UCSC-iGEM-2016/taris_controller/(list of files, drawings)

Other design files:
schematics/mainboard.dch
schematics/mainboard_pcb_v1.dip
