UCSC-iGEM-2016/taris_controller/taris_controller/taris_motors.py

#!/usr/bin/env python

from __future__ import print_function    # reconciles printing between python2 and python3
import os
import io
import taris_reactor as reactor

# Uses pi-blaster to run a PWM from the raspberry pi pins.
# Once pi-blaster is installed on the pi, bash commands 
# can control the PWM output of individual pins.
# 
# Bash examples (taken from https://github.com/sarfata/pi-blaster): 
#
# This command sets pin 17 to 100%:
#### > echo "17=1" > /dev/pi-blaster 
#
# This command sets pin 17 to 20%:
#### > echo "17=0.2" > /dev/pi-blaster 
#
# This command sets pin 17 to 0%:
#### > echo "17=0" > /dev/pi-blaster
#
# This command releases a pin for use as a GPIO or an input again:
#### > echo "release 17" > /dev/pi-blaster
# 
# To override the default list of supported GPIO pins and specify 
# fewer (or more) you can specify a comma separated list of GPIO 
# numbers. This is also the default list:
#### > ./pi-blaster --gpio 4,17,18,27,21,22,23,24,25
#
# To use the BCM2835's PCM peripheral instead of its PWM peripheral
# to time the DMA transfers, pass the option:
#### > ./pi-blaster --pcm
# 
# To invert the pulse (off = pin HIGH, pulse = pin LOW), use:
#### > ./pi-blaster --invert
# 
# To keep pi-blaster running in the foreground without running 
# as a daemon use:
#### > ./pi-blaster -D
# 
# To view help or version information, use:
#### > ./pi-blaster --help
#### > ./pi-blaster --version

#PINd = 22
#PWMd = 0
#PINd = str(PINd)
#PWMd = str(PWMd)
#os.system("echo '" + PINd + "=" + PWMd + "' > /dev/pi-blaster")

class Taris_Motors():
    
    def __init__(self, inPWM, outPWM, naohPWM, heaterPWM, Kp, Ki, Kd, pH_def, temp_def):
        self.inPWM       = inPWM
        self.outPWM      = outPWM
        self.naohPWM     = naohPWM
        self.heaterPWM   = heaterPWM
        
        self.inPIN       = 21         # Inflow motor default pin:    21
        self.outPIN      = 22         # Outflow motor default pin:   22
        self.naohPIN     = 23         # NaOH motor default pin:      23
        self.heaterPIN   = 17         # Heating element default pin: 17

        # PID Function Variables
        self.current_val      = 0.0
        self.end_val          = 0.0
        self.sample_time      = 0.0
        self.integral_prev    = 0.0
        self.error_prev       = 0.0
        self.Kp = Kp
        self.Ki = Ki
        self.Kd = Kd

        # pH Variables
        self.pH_desired     = pH_def  # the pH you desire <3
        self.pH_current     = 0.0     # the pH that is actually happening >.>
        self.fluid_volume   = 2.0     # liters of liquid in the bioreactor
        self.NaOH_molarity  = 0.0001  # grams/liter of NaOH solution to be added
        self.rate_of_NaOH   = 0.0001  # liters/second (based on each motor)

        # Temperature Variables (PI)
        self.desired_temp     = temp_def # Celsius
        self.current_temp     = 0.0
        self.temp_Kp          = 0.0
        self.temp_Ki          = 0.0
        self.temp_error       = 0.0
        self.temp_sample_time = 0.0
        self.temp_curr_time   = 0.0
        self.temp_prev_time   = 0.0
        self.temp_P           = 0.0
        self.temp_I           = 0.0
        self.temp_I_MAX       = 0.0
        self.temp_I_MIN       = 0.0
        self.set_power        = 0.0

        # initiate pi-blaster with only the four default pins above
        os.system("sudo pi-blaster --gpio 17,21,22,23")

    def set_PIN_at_PWM(self, PIN, PWM):
        PIN = str(PIN)
        PWM = str(PWM)
        print("Setting pin " + PIN + " to " + PWM + ".")
        os.system("echo '" + PIN + "=" + PWM + "' > /dev/pi-blaster")

    def set_volume(self, volume):
        self.fluid_volume = volume
        pass

    def set_rate_of_NaOH(self, rate):
        self.rate_of_NaOH = rate
        pass

    def set_NaOH_molarity(self, molarity):
        self.NaOH_molarity = molarity
        pass

    def set_pH_desired(self, pH):
        self.pH_desired = pH
        pass

    def set_temp_desired(self, temp):
        self.desired_temp = temp
        pass

    def bangbang_heater(self, input_temp):
        """
        Simple bang-bang hysteresis control of the heating element.
        """
        upper_threshold = self.desired_temp + 0.5
        lower_threshold = self.desired_temp - 0.5

        if input_temp > upper_threshold:
            self.set_power = 0
        if input_temp < lower_threshold:
            self.set_power = 1
	return self.set_power

    def pH(self, input_pH):
        """
        When run, this function adds NaOH to the bioreactor to adjust pH.

        Designed to be run as a daemon.  Whenever the pH dips 0.1 below the desired
        pH, this function will calculate the volume of NaOH to be added, and will 
        run the motor an amount of time long enough to add that amount (and if not 
        run as a daemon, will pause the entire program).

        Motor rate of NaOH addition and volume must be entered beforehand.

        It is important that this function be given an average of pH values to avoid 
        spikes and noise.

        It's a good idea to pause after using this function to allow the pH stick
        to acclimate.
        """

        moles_of_NaOH = (fluid_volume*(10**(-pH_desired))) - (fluid_volume*(10**(-pH_current)))
        vol_of_NaOH_to_add = moles_of_NaOH / NaOH_molarity
        run_motor_for_how_long = rate_of_NaOH / vol_of_NaOH_to_add

        self.set_PIN_at_PWM(self.naohPIN, 0.1) # 0.1 = run at one-tenth motor power
        time.sleep(run_motor_for_how_long)
        self.set_PIN_at_PWM(self.naohPIN, 0) # 0 = stop the motor

    def PID(self, current_val, end_val, sample_time, integral_prev, error_prev, sensor):
        """
        PID is a feedback control algorithm that determines the output of a system
        input x(t) to stabilize future outputs x(t+n). This allows for regulated
        pulse width modulation (PWM) for "locking" a system to a desired value.

        :param current_val: current input value
        :param end_val: desired system value
        :param sample_time: sampling rate (run PID every x seconds)
        :param integral_prev: previous integral value
        :param error_prev: previous error value
        :return: system value, previous error, integral error
        """

        if current_val != None:
            if integral_prev == None:
                integral_prev = 0.0
                error_prev = 0.0
                current_val = 0.0

            # Define parameters for feedback mechanism
            error_curr = float(end_val) - float(current_val)
            integral = integral_prev + float(error_curr*sample_time) / self.Ki
            derivative = (error_curr - error_prev)/(sample_time * self.Kd)

            # Compute output from above parameters
            y = self.Kp * (error_curr + integral + derivative)

            error_prev = error_curr
            integral_prev = integral

            # pH settings
            if sensor == "pH":
                if error_curr <= 0:
                    y = 0

            # Temperature settings
            elif sensor == "temp":
                if error_curr < 0:
                    y = 0
                elif 10 < error_curr < 20:
                    y = 100 - 200/error_curr
                elif error_curr > 15:
                    y = 100
                    
            elif y < 0:
                y = 0
            
            scaling_factor = 10.0 # don't burn things down            
            y = y/scaling_factor
                
            print(sensor + " output: " + str(y) + ", " + str(integral) + " ," + str(error_curr))
            return (abs(y/100.0), error_prev, integral_prev)
        else:
            return 0
