UCSC-iGEM-2016/taris_controller/taris_controller/taris_reactor.py

from __future__ import print_function
from taris_adc import Taris_ADC as ADC
from taris_sensor import Taris_Sensor as Sensor
from taris_motors import Taris_Motors as Motor
from taris_json import Taris_JSON as IOX
from taris_calibrate import PID_Cal as CAL
import os
import time
from time import gmtime, strftime
import threading

class Taris_Reactor():
    '''Holds the object that runs the bioreactor and handles data aggregation. \
    Requires the Atlas Scientific EZO pH and RTD sensor objects, and the \
    Texas Instruments ADS1115 analog to digital converter object (uses the \
    Adafruit ADS1x15 library.'''

    def __init__(self,
                  adc_address,          \
                  i2c_bus,              \
                  pH_sensor_address,    \
                  temp_sensor_address,  \
                  pwm_frequency,        \
                  sample_frequency,     \
                  pH_def,               \
                  temp_def,             \
                  adc_gain,             \
                  inflow_ads_pin,       \
                  outflow_ads_pin,      \
                  naoh_ads_pin,         \
                  filter_ads_pin,       \
                  server_ip,            \
                  server_post_path,     \
                  server_pull_path):

        # Instantiate ADC (ADS1115) object
        self.ads             = ADC(adc_address, i2c_bus)
        self.ads.setupADC() 
        
        # Instantiate Atlas Objects
        self.temp_sensor     = Sensor(temp_sensor_address,i2c_bus)
        self.pH_sensor       = Sensor(pH_sensor_address,i2c_bus)
        self.adc_gain        = adc_gain
        
        # Network Handler
        self.JSON_Handler = IOX(server_ip, server_post_path, server_pull_path)
        
        #Set RTD Sensor unit and verify
        print("Setting temperature sensor to celsius...")
        temp_unit = "C" # F,C, or K
        self.temp_sensor.write("S," + temp_unit + "\0x0d") # Set to fahrenheit
        q = self.temp_sensor.query("S,?\0x0d")
        
        if str(q) == "?S,"+temp_unit:
            print("Temperature sensor response (C, F, or K): " + str(temp_unit))
        else:
            print("Error setting temperature sensor: " + str(q))
        
        self.pH_sensor.verify()
        self.temp_sensor.verify()
        
        # Clear EZO pH and temperature sensors' internal data
        self.temp_sensor.write("M,CLEAR")
        
        # Internal data
        self.current_pH      = 0
        self.current_temp    = 0
        
        self.inflow_PWM      = 0
        self.outflow_PWM     = 0
        self.naoh_PWM        = 0
        self.filter_PWM      = 0
        self.heater_PWM      = 0
        
        self.inflow_i        = 0
        self.outflow_i       = 0
        self.naoh_i          = 0
        self.filter_i        = 0
        
        self.inflow_rate     = 0
        self.outflow_rate    = 0
        self.filter_rate     = 0
        
        # ADS pin settings        
        self.inflow_ads_pin  = inflow_ads_pin
        self.outflow_ads_pin = outflow_ads_pin
        self.naoh_ads_pin    = naoh_ads_pin
        self.filter_ads_pin  = filter_ads_pin

        # PID parameters
        self.pwm_frequency   = pwm_frequency
        self.sample_frequency= sample_frequency
        self.sample_time     = 1.0 / self.sample_frequency
        self.pH_def          = pH_def
        self.temp_def        = temp_def
        self.temp_output     = 0
        self.pH_output       = 0
        self.temp_error_prev = 0
        self.temp_int_prev   = 0
        self.pH_error_prev   = 0
        self.pH_int_prev     = 0
        
        self.Kp = 0.25
        self.Ki = 0.1
        self.Kd = 0.5
        
        # Instantiate Motor Object
        self.motors          = Motor(self.inflow_PWM, self.outflow_PWM, \
                                     self.naoh_PWM, self.heater_PWM,    \
                                     self.Kp, self.Ki, self.Kd, self.pH_def, self.temp_def)

        # Motor pins
        self.motor1          = 21
        self.motor2          = 22
        self.motor3          = 23
        self.motor4          = 17

        # Control parameters
        self.stop_reactor    = False
        self.time_count      = 0
        self.pH_counter      = 0
        self.pH_counter1     = 0
        self.heater_on       = 0

        self.pH_list         = [0,0,0,0,0,0,0,0,0,0]
        
        
    def cls(self):
        '''Clears the terminal.'''
        os.system('cls' if os.name=='nt' else 'clear')

    def Calibrate_Sensors(self):
        '''UI for sensor calibration selection.'''
        self.cls()
        user_selection = str(input("Please select from the options below:\n\
            1.\tCalibrate pH sensor\n\
            2.\tCalibrate temp sensor\n\
            3.\tCalibrate both temp and pH. Temperature will be used\n\
            \tfor additional pH calibration.\n\
            4.\tExit to main menu.\n>> "))
        if user_selection == '1':
            self.pH_sensor.pH_calibrateSensor()
        elif user_selection == '2':
            self.temp_sensor.temp_calibrateSensor()
        elif user_selection == '3':
            self.pH_sensor.pH_calibrateSensor()
            self.temp_sensor.temp_calibrateSensor()
            setup_temp = self.temp_sensor.getData()
            self.pH_sensor.pH_compensateTemp(setup_temp)
        elif user_selection == '4':
            print("Goodbye.")

    def Run_PWM(self):
        '''UI for motor and PWM testing.'''
        self.cls()
        user_selection = str(input("Please select from the options below:\n\
            1.\tRun motor 1.\n\
            2.\tRun motor 2.\n\
            3.\tRun motor 3.\n\
            4.\tRun motor 4.\n\
            5.\tTurn all motors off.\n\
            6.\tExit to main menu.\n\
            7.\tInsert an aliquot of NaOH.\n>> "))
        if user_selection == '1':
            self.motors.set_PIN_at_PWM(self.motor1, 1.0)
            self.Update_PWM(self.motor1, 1.0)
            self.Run_PWM()
        elif user_selection == '2':
            self.motors.set_PIN_at_PWM(self.motor2, 1.0)
            self.Update_PWM(self.motor2, 1.0)
            self.Run_PWM()
        elif user_selection == '3':
            self.motors.set_PIN_at_PWM(self.motor3, 1.0)
            self.Update_PWM(self.motor3, 1.0)
            self.Run_PWM()
        elif user_selection == '4':
            self.motors.set_PIN_at_PWM(self.motor4, 1.0)
            self.Update_PWM(self.motor4, 1.0)
            self.Run_PWM()
        elif user_selection == '5':
            self.motors.set_PIN_at_PWM(self.motor1, 0)
            self.motors.set_PIN_at_PWM(self.motor2, 0)
            self.motors.set_PIN_at_PWM(self.motor3, 0)
            self.motors.set_PIN_at_PWM(self.motor4, 0)
            self.Run_PWM()
        elif user_selection == '6':
            print("Goodbye.")
        elif user_selection == '7':
            self.motors.set_PIN_at_PWM(self.motor3, 0.5) # 0.5 = run at one-half motor power
            time.sleep(0.05)
            self.motors.set_PIN_at_PWM(self.motor3, 0) # 0 = stop the motor
            self.Run_PWM()
        else:
            print("Input is incorrect.  Please select a number from the menu... o.o")
            self.Run_PWM()
    def Display_Status(self):
        '''Displays relevant information while reactor is running.'''
        self.cls()
        status_message = 'Taris V1.0 Bioreactor | Current time: ' + str(time.strftime("%d-%m-%Y @ %H:%M:%S")) + '\n' +\
            'Temp:   '     + str(self.current_temp)     + '\n' +\
            'pH:     '     + str(self.current_pH)       + '\n' +\
            'Inflow: '     + str(self.inflow_i)         + '\n' +\
            'Outflow:'     + str(self.outflow_i)        + '\n' +\
            'NaOH:   '     + str(self.naoh_i)           + '\n' +\
            'Filter: '     + str(self.filter_i)         + '\n' +\
            'Des. Temp: '  + str(self.temp_def)         + '\n' +\
            'Des. pH: '    + str(self.pH_def)           + '\n'
        print(status_message)
        
        # Make a new JSON and post to the server
        try:
            self.JSON_Handler.make_JSON(self.current_pH,  \
                   self.current_temp,\
                   self.inflow_PWM,  \
                   self.outflow_PWM, \
                   self.naoh_PWM,    \
                   self.filter_PWM,  \
                   self.heater_PWM,  \
                   self.inflow_i,    \
                   self.outflow_i,   \
                   self.naoh_i,      \
                   self.filter_i,    \
                   self.pH_def,      \
                   self.temp_def)
            self.JSON_Handler.post_JSON()
        except:
            pass
        try:
            self.pH_def, self.temp_def = self.JSON_Handler.pull_JSON()
        except:
            pass
        self.motors.set_temp_desired(self.temp_def)
        self.motors.set_pH_desired(self.pH_def)
        
    def Sample_Bioreactor(self):
        '''Gets data from bioreactor sensors.  Run this function at 1 Hz.'''
        # Get sensor values
        self.Check_Sensors()
        
        # Initialize the heater
        # safe-guard in case RTD comes out of water
        # thermal switch
        temp_upper_threshold = self.temp_def + 0.05
        temp_lower_threshold = self.temp_def - 0.05
        if self.current_temp > temp_upper_threshold:
            self.heater_PWM = 0
        if self.current_temp < temp_lower_threshold:
            self.heater_PWM = 1
        self.motors.set_PIN_at_PWM(self.motor4, self.heater_PWM)
        
        # Initialize NaOH moderation of pH (add drop every 10-20s until level)
        self.pH_list[self.pH_counter1] = self.current_pH
        pH_average = (self.pH_list[0] + \
                     self.pH_list[1] + \
                     self.pH_list[2] + \
                     self.pH_list[3] + \
                     self.pH_list[4] + \
                     self.pH_list[5] + \
                     self.pH_list[6] + \
                     self.pH_list[7] + \
                     self.pH_list[8] + \
                     self.pH_list[9])/10.0
        self.pH_counter += 1
        self.pH_counter1 += 1
        if self.pH_counter1 > 9:
            self.pH_counter1 = 0
        pH_lower_threshold = self.pH_def - 0.05
        
        # if pH goes too low show an error that NaOH is depleted
        # or motor is stopped
        
        # if pH_average > pH_lower_threshold:
        #     self.pH_counter = 0
        if pH_average < pH_lower_threshold:
            if self.pH_counter >= 5:
                self.pH_counter = 0
                self.motors.set_PIN_at_PWM(self.motor3, 0.5) # 0.5 = run at one-half motor power
                time.sleep(0.05)
                self.motors.set_PIN_at_PWM(self.motor3, 0) # 0 = stop the motor
        
        # Get motor currents
        self.Query_Motor_Current()

    def Run_Bioreactor(self):
        '''Runs the bioreactor sampler at 1Hz.'''
        
        #@ Instantiate PID test jig
        #@ self.cal = CAL(self.Kp, self.Ki, self.Kd)
        #@ self.cal.runCal()

        time_counter = 0
        
        try:
            file = open("data_Log.txt", "w")
            file.write(strftime("%a, %d %b %Y %H:%M:%S ", gmtime()) + "\n")
            file.write("Bioreactor Log of Temp and pH\nLon Blauvelt\nTime(s)   Temp   pH\n\n")
            while self.stop_reactor==False:
                # Get updated values and run control
                self.Sample_Bioreactor()

                # Display current values
                self.Display_Status()
                #@ self.Kp, self.Ki, self.Kd = self.cal.updateCal(self.current_temp, self.heater_PWM)

                # Update motor PWM
                # self.motors.set_PIN_at_PWM(self.motor4, self.heater_PWM)            
                time.sleep(1)
                file.write(str(time_counter) + " " + str(self.current_temp) + " " + str(self.current_pH) + "\n")
                time_counter += 1
        except KeyboardInterrupt:
            file.close()
            pass
            
    def Check_Sensors(self):
        '''Gets current pH and temp from the EZO pH and RTD sensors.'''
        self.current_pH = self.pH_sensor.getData()
        self.current_temp = self.temp_sensor.getData()
        
    def V_to_I(self,voltage):
        '''Converts ADS1115 voltage reading to a current, since the value \
        at each of its pins measure the drop across a current sensor resistor \
        respective to each motor.'''
        res = 0.1
        return int(voltage)/res
        
    def Flowrate_to_PWM(self,input_rate):
        '''Converts desired flowrate to a PWM value.'''
        converted_value = 0.0431*input_rate - 0.5509
        return converted_value

    def Query_Motor_PWM(self):
        # Run a PID on the temperature and update PWM
        self.heater_PWM, self.temp_error_prev, self.temp_int_prev = self.motors.PID(self.current_temp, \
                                                self.temp_def,     \
                                                self.sample_time,  \
                                                self.temp_int_prev,\
                                                self.temp_error_prev, "temp")
        # Run a PID on the pH and update PWM
        self.naoh_PWM, self.pH_error_prev, self.pH_int_prev = self.motors.PID(self.current_pH, \
                                                self.pH_def,     \
                                                self.sample_time,\
                                                self.pH_int_prev,\
                                                self.pH_error_prev, "pH")

    def Update_PWM(self, PIN, PWM):
        '''Get the new PWM from the motors program.'''
        if   PIN is 17:
            self.heater_PWM  = PWM
        elif PIN is 21:
            self.inflow_PWM  = PWM
        elif PIN is 22:
            self.outflow_PWM = PWM
        elif PIN is 23:
            self.naoh_PWM    = PWM

    def Query_Motor_Current(self):
        '''Returns the current flowing through each motor by measuring the \
        voltage drop across a current sense resistor.'''
        self.inflow_i  = self.V_to_I(self.ads.readADC(self.inflow_ads_pin,self.adc_gain))
        self.outflow_i = self.V_to_I(self.ads.readADC(self.outflow_ads_pin,self.adc_gain))
        self.naoh_i    = self.V_to_I(self.ads.readADC(self.naoh_ads_pin,self.adc_gain))
        self.filt_i    = self.V_to_I(self.ads.readADC(self.filter_ads_pin,self.adc_gain))
