UCSC-iGEM-2016/taris_controller/(commit log)

2016-08-06 Added basic Taris interface. Next commmit will include calibration functionality as well as minor changes to existing interface tools.
2016-08-08 Commented more code, adding calibration methods and fixing up reactor UI
    [taris_adc.py, taris_hw.py, taris_reactor.py, taris_sensor.py]
2016-08-08 Completed sensor calibration methods, they now need to be tested. Concatenated work that Lon and I did and patched some inconsistencies in taris_reactor. We will now work on JSON and PID.
2016-08-10 Partial PWM and small stuff.
2016-08-10 Small changes to PWM
2016-08-10 PWM and JSON Edits
2016-08-11 Modified PWM
2016-08-19 PWM prompts, PID testing implementation, and motor functionality.
2016-08-23 Pull and threads daemonized (need to fix stopping).
    [taris_json.py]
2016-09-01 Added to PID, incorporated PID calibrator, other small syntax changes
2016-09-12 PID Update.
2016-09-13 PI and PID tweaking.
2016-09-13 PI and PID stuff.
2016-09-19 Heating control implemented.
2016-09-24 Fixed some overnight bugs; added some try/excepts.
    [taris_hw.py, taris_motors.py, taris_reactor.py, taris_sensor.py]
2016-10-19 Create SCHEMATIC_INFO
